edlovesjava/DOTplatform/(commit log)

2026-01-03 Initial DOTplatform repository
    Platform for DOT handheld gaming devices:
    - Hardware spec (ATtiny85 + MAX7219 + 8x8 LED)
    - DotPlatform Arduino library framework
    - 2-pin / 3-input button scheme via chord detection
    - Expansion port for cartridge system
2026-01-04 Clarify current breadboard setup vs future handheld plans
    - README: Added "Current Hardware" section with breadboard components
    - README: Moved future features under "Future Plans"
    - README: Updated Quick Start with actual wiring and programming steps
    - SPEC.md: Added "Current Setup: Breadboard Prototype" section
    - SPEC.md: Marked everything else as "Future Plans"
2026-01-04 Add PCB design specification for DOT handheld
    - 2.5" x 1.5" through-hole PCB with DIP sockets
    - 3xAAA battery holder on back (4.5V, no boost needed)
    - 8x8 LED matrix with discrete MAX7219 DIP-24
    - 2-3 button config: LEFT, RIGHT, optional FIRE
    - FIRE button wires both pins for hardware chord detection
    - Expansion header and ISP programming header
2026-01-06 Add isolation diodes for FIRE button to prevent sneak path
    1N4148 diodes between PB3/PB4 and the FIRE button prevent
    current from flowing backwards when individual buttons are
    pressed, which was causing phantom chord detection.
2026-01-06 Add breadboard tutorial and programmer setup guide
    - Updated README for 3-button setup with diodes and 3xAAA power
    - Created docs/BREADBOARD_TUTORIAL.md with step-by-step build guide,
    BOM with price estimates, and alternate configurations
    - Created docs/PROGRAMMER_SETUP.md covering Arduino Nano as ISP,
    USB-TTL adapter, and USBtinyISP options
